cutlasses/GlitchDelayV2/build/schematic image.png

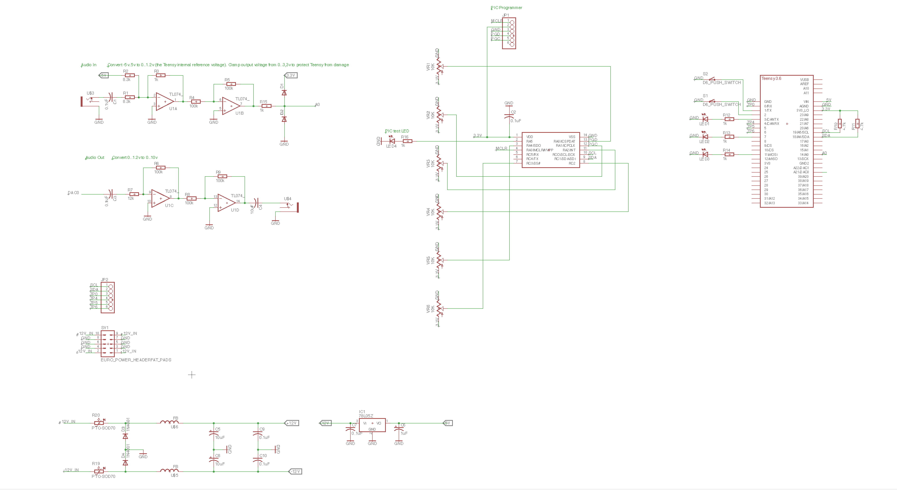
build/schematic image.png
