cutlasses/GlitchDelayV2/build/v2/Bottom Schematic.png

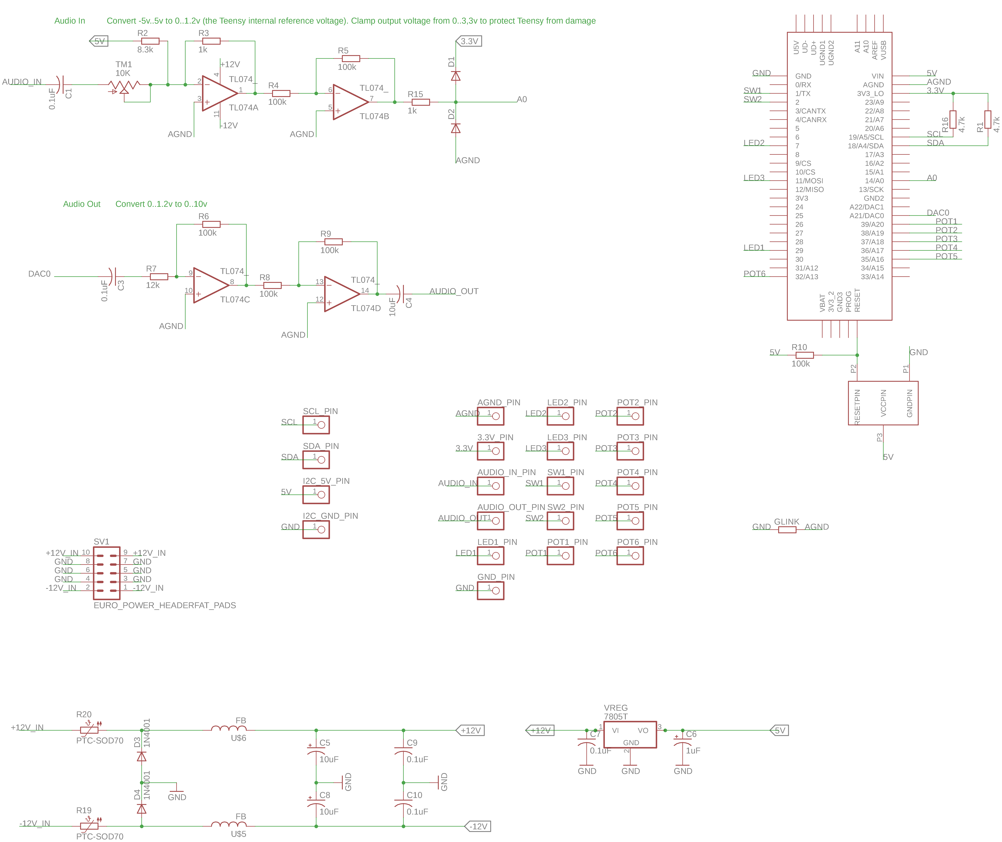
build/v2/Bottom Schematic.png
