cutlasses/GlitchDelayV2/build/v2/Top Schematic.png

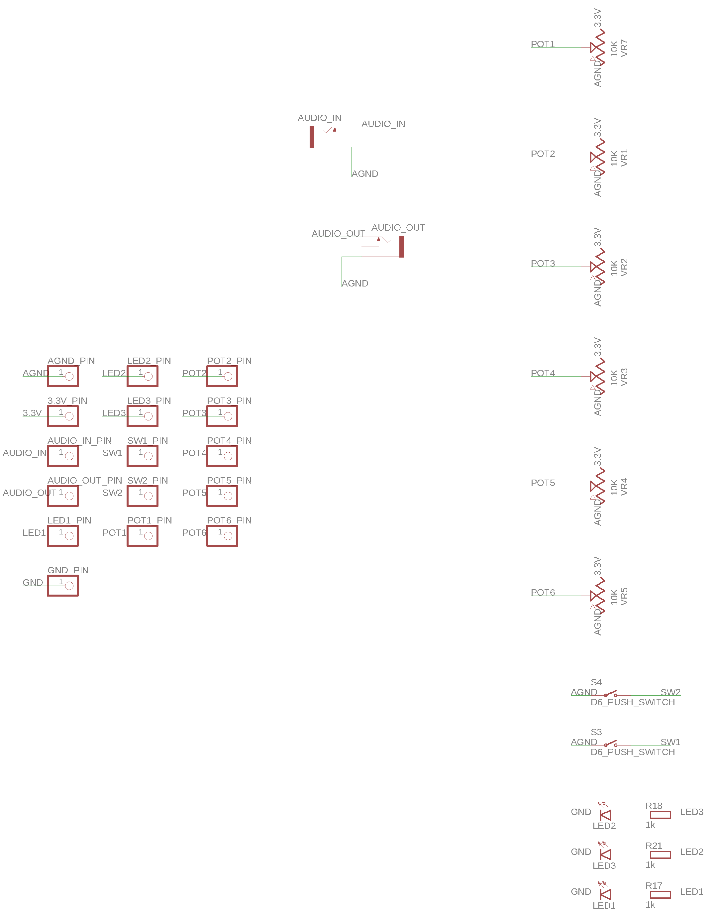
build/v2/Top Schematic.png
