cutlasses/GlitchDelayV2/build/board image.png

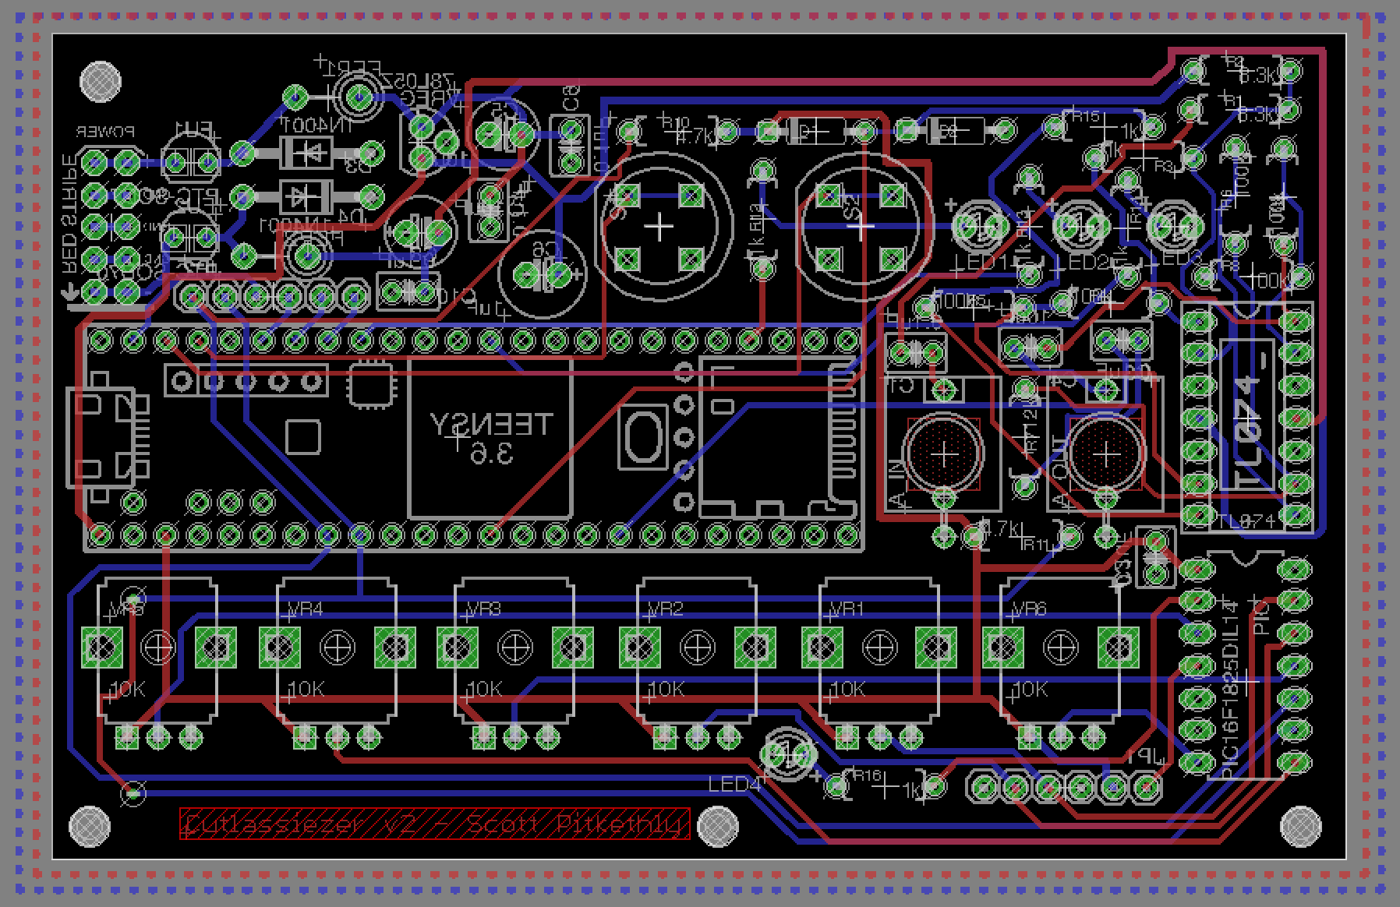
build/board image.png
