cutlasses/GlitchDelayV2/(threads)

Thread 1 (2018-09-24):

Photo of completed PCB's

grinchdubs, 2018-09-24:
Hello Cutlasses,

I was wondering if it would be at all possible to tak a photo of your completed boards. I was able to get copies of your boards made however when trying to populate them from the BOM I am getting lost with a few parts. I feel like a photo of a completed board would help me out a bit.

Thanks
Grinchdubs

cutlasses, 2018-09-24:
Hi Grinchdubs,

Cool you are building a GlitchDelay, you're the first person I know of to
get PCBs made. Are you building the single PCB version, or the version with
2 PCBs that stack?

Cheers,
Scott (Cutlasses)

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

grinchdubs, 2018-09-24:
w00t! I actually got the version with the 2 stacked pcbs made.

cutlasses, 2018-09-24:
I have these ones, is there anything in particular you want to see?

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

grinchdubs, 2018-09-24:
It would be great to get some shots of the bottom board on the teensy side, in addition trying to figure out how what you with with that row if pins you call for on the side. Also not sure what the glink is.

grinchdubs, 2018-09-24:
Let me know if email or some other form of communication is better

cutlasses, 2018-09-24:
My email is spitkethly@gmail.com <mailto:spitkethly@gmail.com>

The glink connects analog ground and digital ground, you can just use a bit of wire (a resistor leg works well).

I’ll take some pictures of the underneath tomorrow.

Cheers,
Scott

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

cutlasses, 2018-09-25:
It occurred to me you can't see the images I sent you (I hadn't realised this was going through Github comments). Email me at spitkethly@gmail.com
