cutlasses/GlitchDelayV2/build/eagle board.brd

## EAGLE design build/eagle board.brd (2018-01-02)

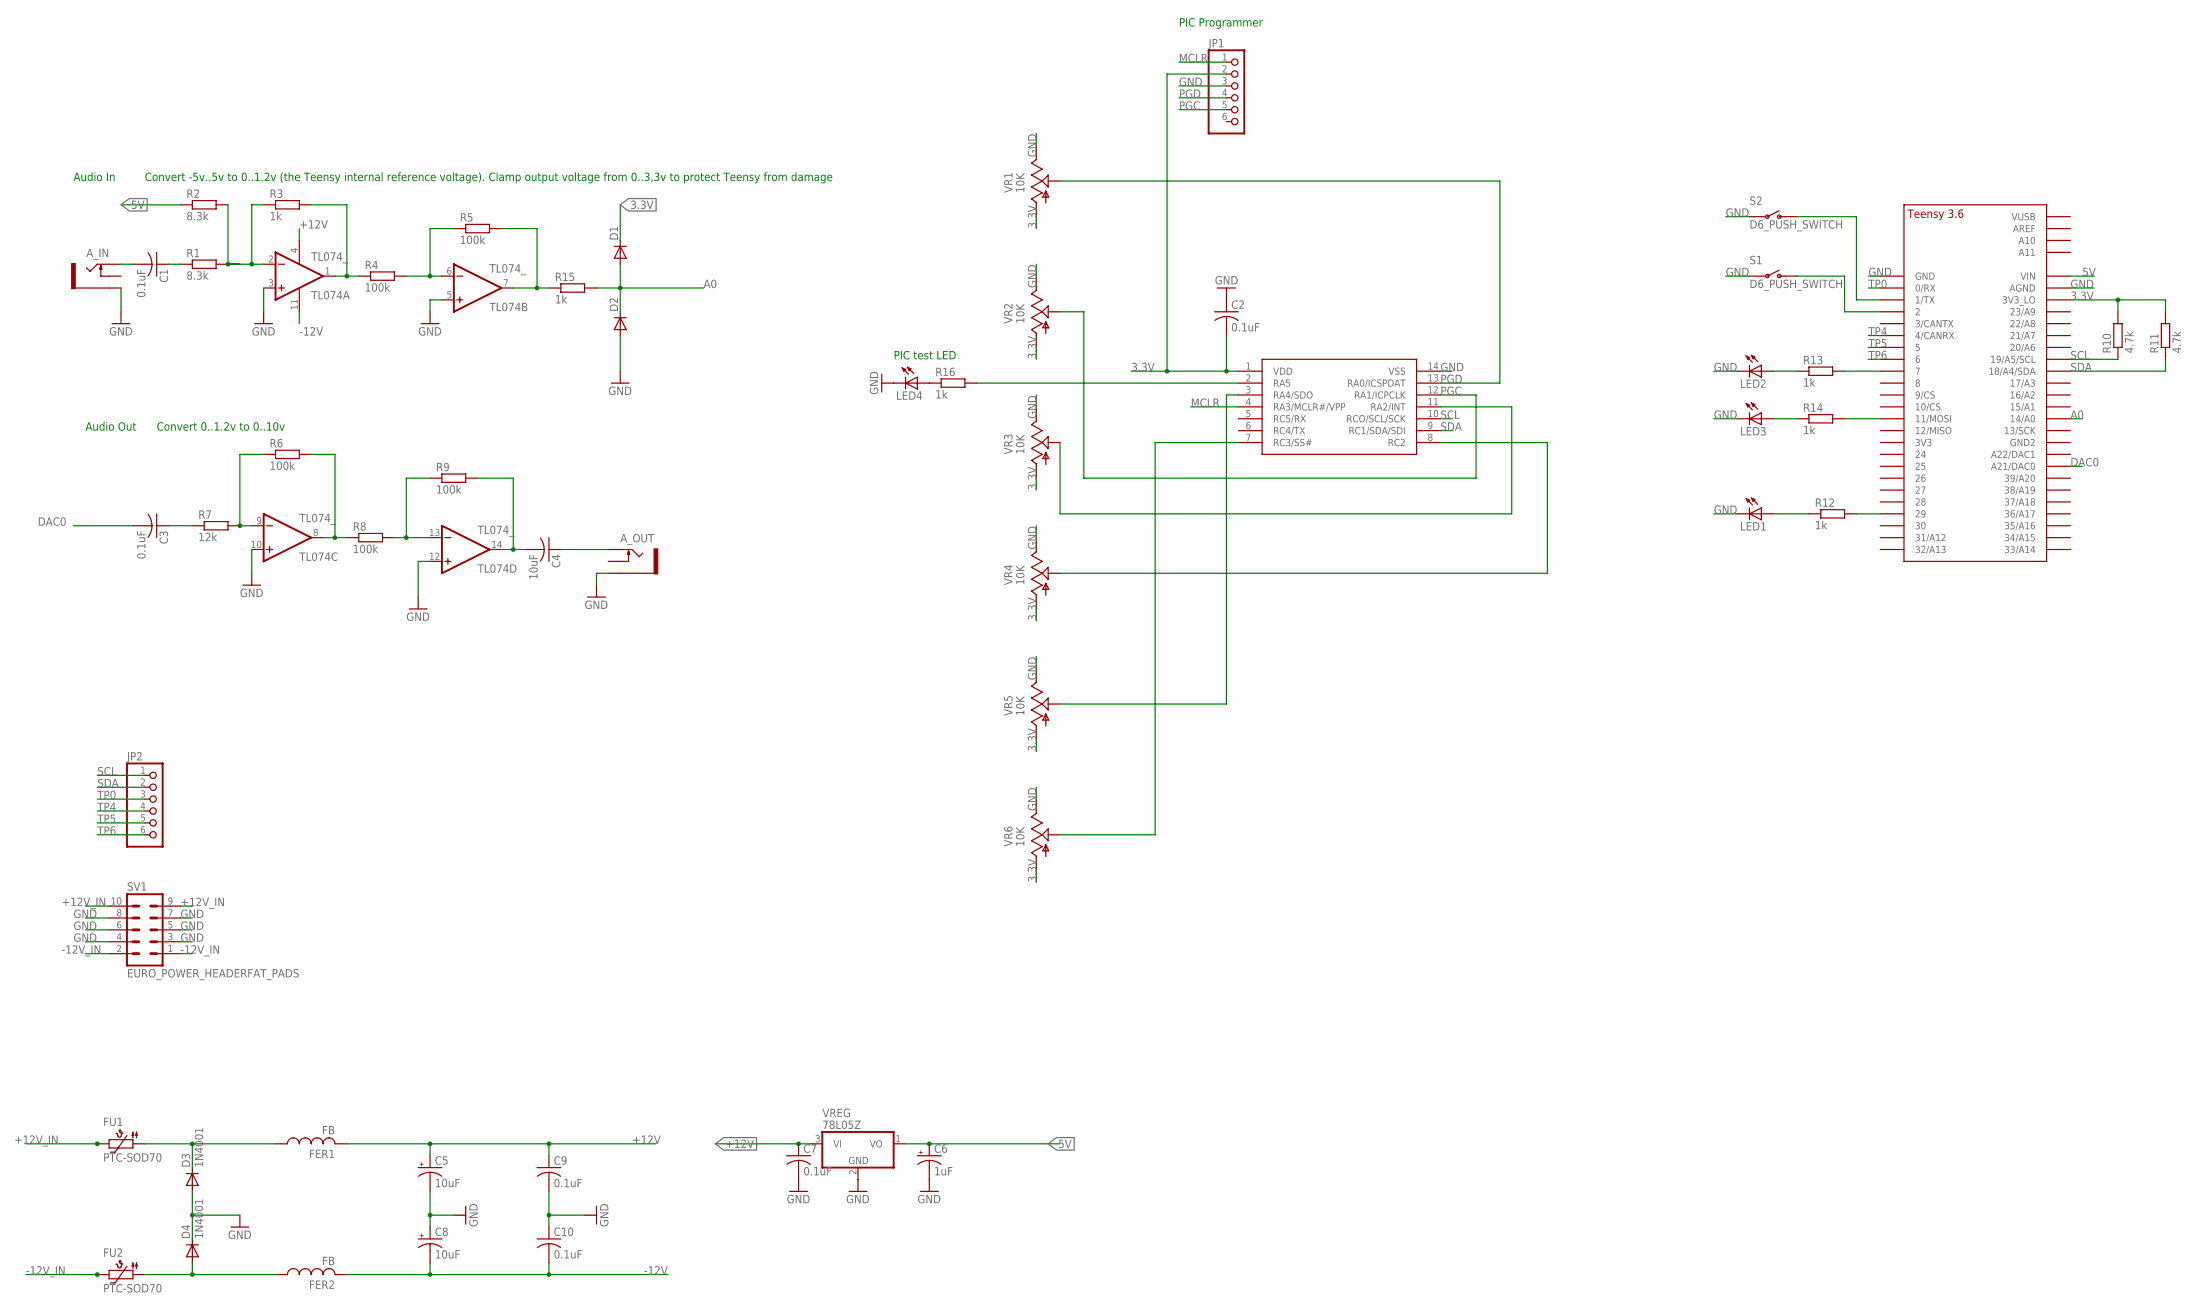
[picture p5: schematic eagle schematic.sch]

Parts:
A_IN: THONKICONNNEW; WQP-PJ301M-12_JACK
A_OUT: THONKICONNNEW; WQP-PJ301M-12_JACK
C1, C2, C3, C7, C9, C10: 0.1uF; C025-030X050
C4: 10uF; C025-030X050
C5, C8: 10uF; E2,5-6E
C6: 1uF; E2,5-7
D1, D2: SMALL_DIODEDO35-7; DO35-7
D3, D4: 1N4001; DO41-10
FER1, FER2: FB
FU1, FU2: PTC-SOD70; SOD70
JP1, JP2: PINHD-1X6; 1X06
LED1, LED2, LED3, LED4: LED3MM
PIC: PIC16F1825DIL14; DIL14
R1, R2: 8.3k; 7MM_RESISTOR
R3, R12, R13, R14, R15, R16: 1k; 7MM_RESISTOR
R4, R5, R6, R8, R9: 100k; 7MM_RESISTOR
R7: 12k; 7MM_RESISTOR
R10, R11: 4.7k; 7MM_RESISTOR
S1, S2: D6_PUSH_SWITCH
SV1: EURO_POWER_HEADERFAT_PADS; EURO_PWR_HEADER_FAT
TL074: TL074_; DIL14
U$1: TEENSY_3.5/3.6_BASIC
VR1, VR2, VR3, VR4, VR5, VR6: 10K; 9MM_SNAP-IN_POT
VREG: 78L05Z; TO92

Connections:
3.3V: C2.2, D1.C, JP1.2, PIC.1 (VDD), R10.2, R11.2, U$1.3V3_LO, VR1.1 (A), VR2.1 (A), VR3.1 (A), VR4.1 (A), VR5.1 (A), VR6.1 (A)
5V: C6.+, R2.1, U$1.VIN, VREG.1 (VO)
+12V: C5.+, C7.1, C9.1, FER1.P$2 (2), TL074.4 (V+), VREG.3 (VI)
+12V_IN: FU1.2, SV1.9, SV1.10
-12V: C8.-, C10.2, FER2.P$2 (2), TL074.11 (V-)
-12V_IN: FU2.2, SV1.1, SV1.2
A0: D1.A, D2.C, R15.2, U$1.14/A0
DAC0: C3.2, U$1.21/DAC0 (A21/DAC0)
GND: A_IN.P$3_SLEEVE (SLEEVE), A_OUT.P$3_SLEEVE (SLEEVE), C2.1, C5.-, C6.-, C7.2, C8.+, C9.2, C10.1, D2.A, D3.A, D4.C, JP1.3, LED1.K (C), LED2.K (C), LED3.K (C), LED4.K (C), PIC.14 (VSS), S1.P$3, S1.P$4, S2.P$3, S2.P$4, SV1.3, SV1.4, SV1.5, SV1.6, SV1.7, SV1.8, TL074.3 (+IN), TL074.5 (+IN), TL074.10 (+IN), TL074.12 (+IN), U$1.AGND, U$1.GND, VR1.3 (E), VR2.3 (E), VR3.3 (E), VR4.3 (E), VR5.3 (E), VR6.3 (E), VREG.2 (GND)
MCLR: JP1.1, PIC.4 (RA3/MCLR#/VPP)
unnamed: LED4.A, R16.1
unnamed: A_IN.P$1_TIP (TIP), C1.2
unnamed: R1.2, R2.2, R3.1, TL074.2 (-IN)
unnamed: R3.2, R4.1, TL074.1 (OUT)
unnamed: PIC.2 (RA5), R16.2
unnamed: R4.2, R5.1, TL074.6 (-IN)
unnamed: C1.1, R1.1
unnamed: R5.2, R15.1, TL074.7 (OUT)
unnamed: LED1.A, R12.1
unnamed: PIC.11 (RA2/INT), VR3.2 (S)
unnamed: PIC.8 (RC2), VR4.2 (S)
unnamed: PIC.3 (RA4/SDO), VR5.2 (S)
unnamed: C3.1, R7.1
unnamed: R6.1, R7.2, TL074.9 (-IN)
unnamed: PIC.7 (RC3/SS#), VR6.2 (S)
unnamed: R6.2, R8.1, TL074.8 (OUT)
unnamed: R12.2, U$1.29
unnamed: R8.2, R9.1, TL074.13 (-IN)
unnamed: LED2.A, R13.1
unnamed: S1.P$1 (O), S1.P$2 (O), U$1.2
unnamed: C4.2, R9.2, TL074.14 (OUT)
unnamed: A_OUT.P$1_TIP (TIP), C4.1
unnamed: LED3.A, R14.1
unnamed: S2.P$1 (O), S2.P$2 (O), U$1.1/TX
unnamed: R13.2, U$1.7
unnamed: R14.2, U$1.11/MOSI
unnamed: D3.C, FER1.P$1 (1), FU1.1
unnamed: D4.A, FER2.P$1 (1), FU2.1
PGC: JP1.5, PIC.12 (RA1/ICPCLK), VR2.2 (S)
PGD: JP1.4, PIC.13 (RA0/ICSPDAT), VR1.2 (S)
SCL: JP2.1, PIC.10 (RCO/SCL/SCK), R10.1, U$1.19/A5/SCL
SDA: JP2.2, PIC.9 (RC1/SDA/SDI), R11.1, U$1.18/A4/SDA
TP0: JP2.3, U$1.0/RX
TP4: JP2.4, U$1.4/CANRX
TP5: JP2.5, U$1.5
TP6: JP2.6, U$1.6

Notes on the sheet:
Audio In
Audio Out
Convert -5v..5v to 0..1.2v (the Teensy internal reference voltage). Clamp output voltage from 0..3,3v to protect Teensy from damage
Convert 0..1.2v to 0..10v
PIC Programmer
PIC test LED

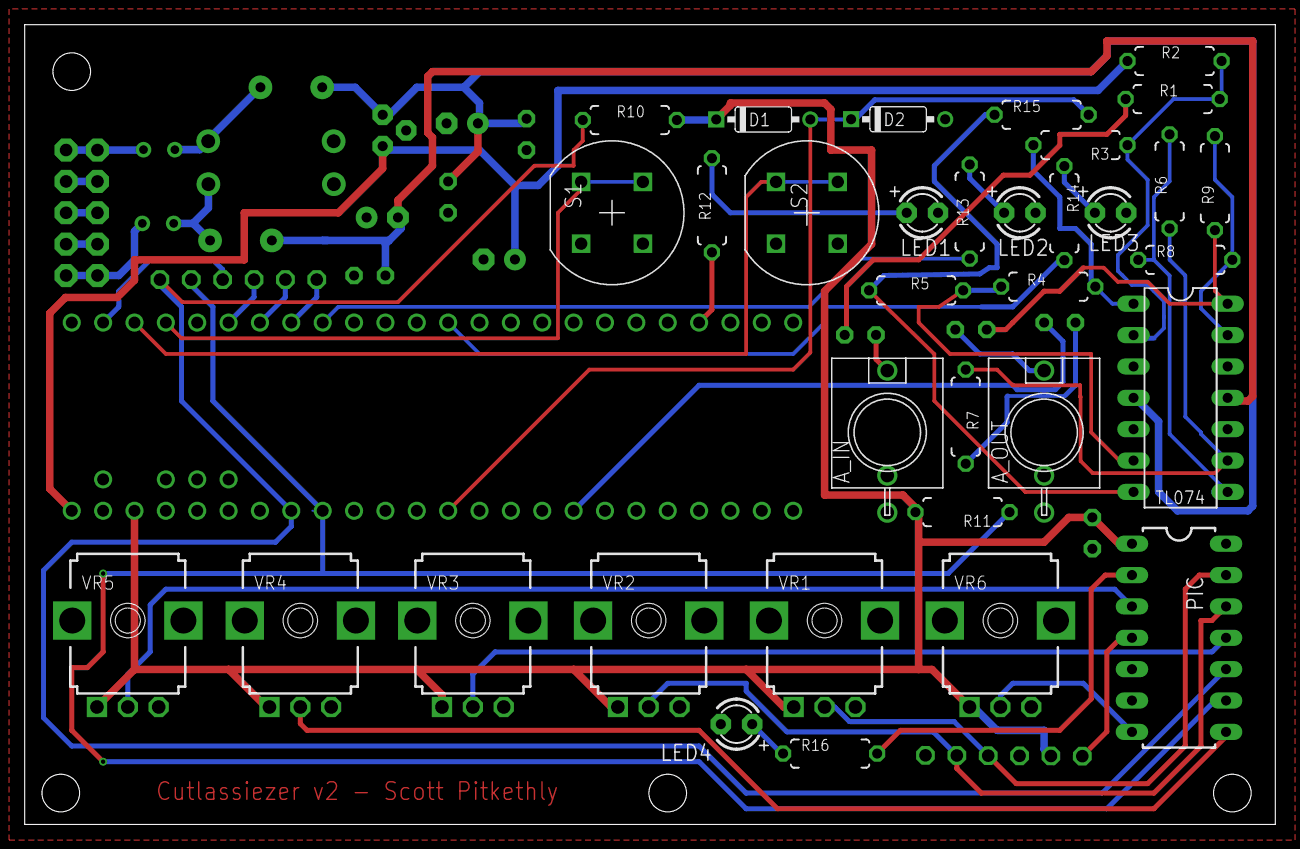
[picture p6: board eagle board.brd from above]

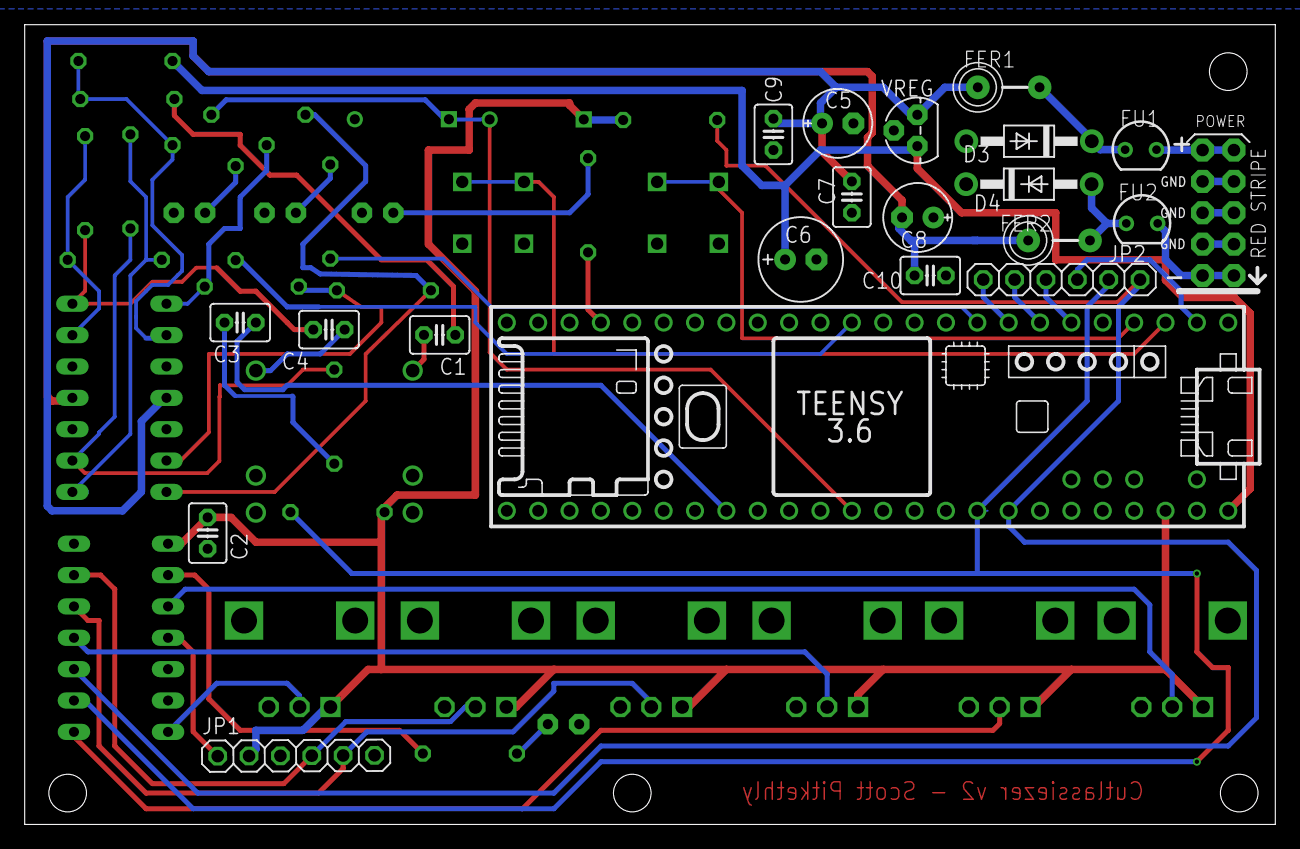
[picture p7: board eagle board.brd from below]

Board: 2 copper layers, 101.3 x 64.8 mm, 55 parts (21 on the bottom side), 46 nets.
