cutlasses/GlitchDelayV2/(commit log)

2017-08-06 Initial commit
    Currently just a copy of V1
2017-08-06 Introducing I2C_DIAL
2017-08-07 Fixing LEDs
2017-08-08 Pot now read correctly!
    Arduino supports lambdas!
    [GlitchDelayInterface.ino]
2017-08-08 Audio working with new board!
    A bit noisy for some reason
2017-08-12 Updated PIC code
    PIC now reads only connected pots, and in order they are mounted on PCB.
2017-10-09 Implementing TeensyJuce
2017-12-09 Lots of changes (from plug in version)
    Reverse head added
    Freeze mode added
    Dials remapped (interface no longer exposes dials, just values, to make
    it easier to remap)
    [GlitchDelayEffect.h, GlitchDelayEffect.ino, GlitchDelayInterface.h, GlitchDelayInterface.ino, GlitchDelayV2.ino]
2018-02-21 Adding support for Teensy based interface (instead of PIC)
    Using ADC library to allow all pots to connect to Teensy instead of PIC
2018-02-21 Turning on define which matches attached build docs
2018-02-22 Adding ADC support
    Pots can now be read on Teensy
2018-05-15 Fixes for new PCB
    [GlitchDelayInterface.h, GlitchDelayInterface.ino, Interface.h, Interface.ino]
2018-05-15 Setting voltage reference
2018-06-25 Adding schematic for top board
2018-06-25 Adding Gerbers
2018-07-29 Using remote I2C interface for CV control
    Adding CV_DIAL which wraps together the on-board pot and off-board CV
2021-08-22 Removing audio adaptor defines
    Conflict with latest teensy libs?
